amonbenson/esp.seq/hardware/esp.seq/esp.seq.kicad_pcb

## KiCad design hardware/esp.seq/esp.seq.kicad_pcb (2022-11-18)

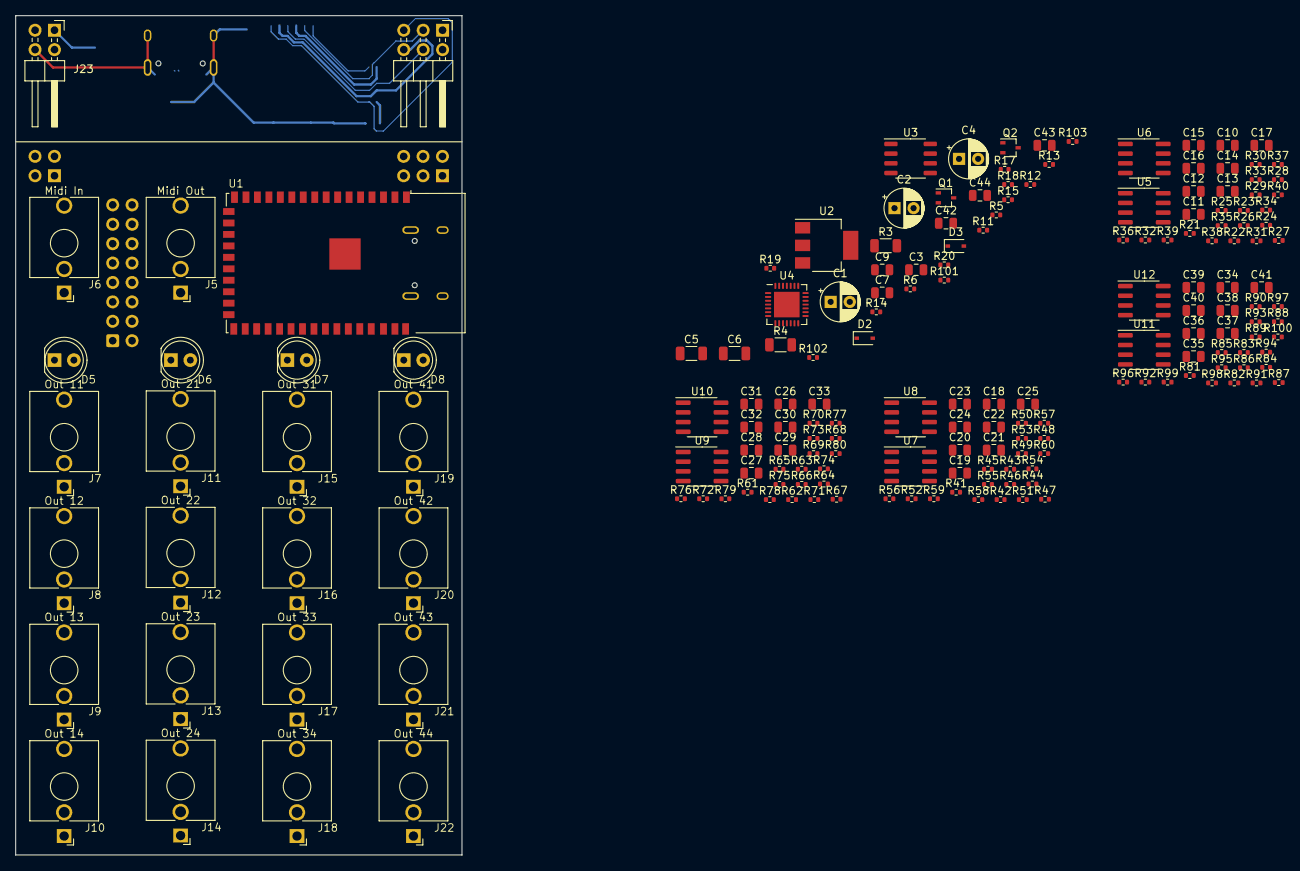
[picture p1: board esp.seq.kicad_pcb from above]

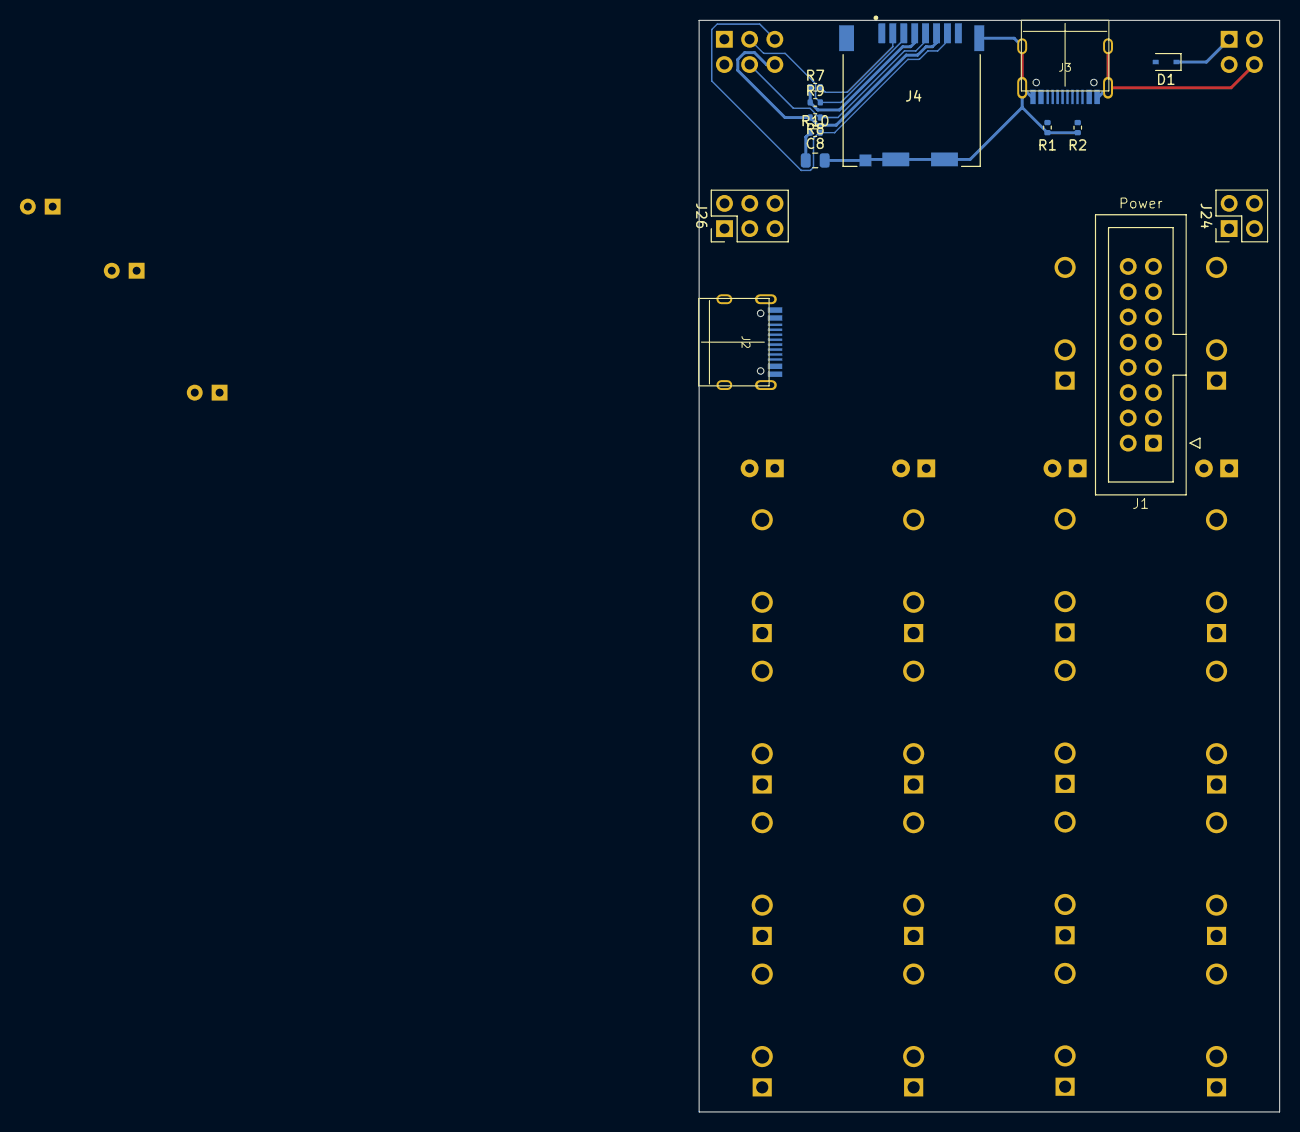
[picture p2: board esp.seq.kicad_pcb from below]

Board: 2 copper layers, 58.4 x 109.9 mm, 193 parts (14 on the bottom side), 149 nets.

Parts:
C1, C2, C4: 10u; CP_Radial_D5.0mm_P2.50mm
C3, C7, C8, C44: 100n; C_0805_2012Metric
C5, C6: 22u; C_1206_3216Metric
C9, C42: 1u; C_0805_2012Metric
C10, C12, C14, C16, C18, C20, C22, C24, C26, C28, C30, C32, C34, C36, C38, C40: 470n; C_0805_2012Metric
C11, C13, C15, C17, C19, C21, C23, C25, C27, C29, C31, C33, C35, C37, C39, C41: 220n; C_0805_2012Metric
C43: 10u; C_0805_2012Metric
D1, D3: 1N5819WS; D_SOD-323
D2: 1N4148WS; D_SOD-323
D5, D6, D7, D8: LED_Red; LED_D5.0mm
J1: Conn_02x08; IDC-Header_2x08_P2.54mm_Vertical
J2, J3: USB-C; TYPE-C-31-M-12
J4: Micro_SD_Card; HRS_DM3CS-SF
J5, J6: PJ-301M-3
J7, J8, J9, J10, J11, J12, J13, J14, J15, J16, J17, J18, J19, J20, J21, J22: PJ-301M-2
J23: Conn_01x04_Male; PinHeader_2x02_P2.54mm_Horizontal
J24: Conn_01x04_Male; PinHeader_2x02_P2.54mm_Vertical
J25: Conn_01x06_Male; PinHeader_2x03_P2.54mm_Horizontal
J26: Conn_01x06_Male; PinHeader_2x03_P2.54mm_Vertical
Q1, Q2: SS8050; SOT-323_SC-70
R1, R2, R11, R12: 5.1k; R_0402_1005Metric
R3, R4: 47; R_1206_3216Metric
R5, R17, R18, R19, R20: 220; R_0402_1005Metric
R6: 470; R_0402_1005Metric
R7, R8, R9, R10, R14: 47k; R_0402_1005Metric
R13: 22k; R_0402_1005Metric
R15, R25, R30, R35, R40, R45, R50, R55, R60, R65, R70, R75, R80, R85, R90, R95, R100: 1k; R_0402_1005Metric
R21, R22, R26, R27, R31, R32, R36, R37, R41, R42, R46, R47, R51, R52, R56, R57, R61, R62, R66, R67, R71, R72, R76, R77, R81, R82, R86, R87, R91, R92, R96, R97, R101, R102, R103: 10k; R_0402_1005Metric
R23, R28, R33, R38, R43, R48, R53, R58, R63, R68, R73, R78, R83, R88, R93, R98: 220k; R_0402_1005Metric
R24, R34, R44, R54, R64, R74, R84, R94: 330k; R_0402_1005Metric
R29, R39, R49, R59, R69, R79, R89, R99: 100k; R_0402_1005Metric
U1: ESP32-S2-WROVER
U2: AMS1117-3.3; SOT-223-3_TabPin2
U3: 6N137; SO-8_3.9x4.9mm_P1.27mm
U4: CP2102; QFN-28-1EP_5x5mm_P0.5mm_EP3.35x3.35mm
U5, U6, U7, U8, U9, U10, U11, U12: TL072; SOIC-8_3.9x4.9mm_P1.27mm

Connections:
+3.3V: C6.1, C43.2, C44.2, J26.1, R3.2, R6.1, R15.1, R103.2, U1.2 (3V3), U2.2 (VO), U4.6 (VDD), U4.7 (VREGIN)
+5V: C4.1, C5.1, C7.1, D3.1 (K), J1.11, J1.12, J24.1, U2.3 (VI), U3.8 (VCC)
+12V: C1.1, C3.2, J1.9, J1.10, U5.8 (V+), U6.8 (V+), U7.8 (V+), U8.8 (V+), U9.8 (V+), U10.8 (V+), U11.8 (V+), U12.8 (V+)
-12V: C2.2, C3.1, J1.1, J1.2, U5.4 (V-), U6.4 (V-), U7.4 (V-), U8.4 (V-), U9.4 (V-), U10.4 (V-), U11.4 (V-), U12.4 (V-)
/CON_+3.3V: C8.1, J4.4 (VDD), J25.1, R7.1, R9.1, R10.1
/CON_+5V: D1.1 (K), J23.1
/CON_FSPI_CLK: J4.5 (CLK), J25.4, R8.1
/CON_FSPI_CS: J4.2 (DAT3/CD), J25.2, R7.2
/CON_FSPI_MISO: J4.7 (DAT0), J25.5, R10.2
/CON_FSPI_MOSI: J4.3 (CMD), J25.3, R9.2
/CON_USB_D+: J3.A6 (D+), J3.B6 (D+), J23.3
/CON_USB_D-: J3.A7 (D-), J3.B7 (D-), J23.2
/CON_VBUS: D1.2 (A), J3.A4 (VBUS), J3.A9 (VBUS), J3.B4 (VBUS), J3.B9 (VBUS)
DTR: Q2.2 (E), R101.1, U4.28 (~DTR)
EN: C42.1, Q1.3 (C), R103.1, U1.41 (EN)
FSPI_CLK: J26.4, U1.30 (IO36)
FSPI_CS: J26.2, U1.28 (IO34)
FSPI_MISO: J26.5, U1.31 (IO37)
FSPI_MOSI: J26.3, U1.29 (IO35)
GND: C1.2, C2.1, C4.2, C5.2, C6.2, C7.2, C9.2, C11.2, C13.2, C15.2, C17.2, C19.2, C21.2, C23.2, C25.2, C27.2, C29.2, C31.2, C33.2, C35.2, C37.2, C39.2, C41.2, C42.2, C43.1, C44.1, D5.1 (K), D6.1 (K), D7.1 (K), D8.1 (K), J1.3, J1.4, J1.5, J1.6, J1.7, J1.8, J2.A1 (GND), J2.A12 (GND), J2.B1 (GND), J2.B12 (GND), J2.S1 (SHIELD), J5.S, J7.S, J8.S, J9.S, J10.S, J11.S, J12.S, J13.S, J14.S, J15.S, J16.S, J17.S, J18.S, J19.S, J20.S, J21.S, J22.S, J24.4, J26.6, R11.2, R12.2, R14.1, R24.2, R29.2, R34.2, R39.2, R44.2, R49.2, R54.2, R59.2, R64.2, R69.2, R74.2, R79.2, R84.2, R89.2, R94.2, R99.2, U1.1 (GND), U1.26 (GND), U1.42 (GND), U1.43 (GND), U2.1 (GND), U3.5 (GND), U4.3 (GND), U4.29 (GND)
GND1: C8.2, J3.A1 (GND), J3.A12 (GND), J3.B1 (GND), J3.B12 (GND), J3.S1 (SHIELD), J4.6 (VSS), J4.9 (SHIELD), J23.4, J25.6, R1.2, R2.2, R8.2
IO0: Q2.3 (C), U1.3 (IO00)
IO1: R21.1, U1.4 (IO01)
IO2: R26.1, U1.5 (IO02)
IO3: R31.1, U1.6 (IO03)
IO4: R36.1, U1.7 (IO04)
IO5: R41.1, U1.8 (IO05)
IO6: R46.1, U1.9 (IO06)
IO7: R51.1, U1.10 (IO07)
IO8: R56.1, U1.11 (IO08)
IO9: R61.1, U1.12 (IO09)
IO10: R66.1, U1.13 (IO10)
IO11: R71.1, U1.14 (IO11)
IO12: R76.1, U1.15 (IO12)
IO13: R81.1, U1.16 (IO13)
IO14: R86.1, U1.17 (IO14)
IO15: R91.1, U1.18 (IO15)
IO16: R96.1, U1.19 (IO16)
IO39: R17.1, U1.33 (IO39)
IO40: R18.1, U1.34 (IO40)
IO41: R19.1, U1.35 (IO41)
IO42: R20.1, U1.36 (IO42)
unnamed: C9.1, R13.1, R14.2, U4.8 (VBUS)
unnamed: C10.1, R23.1, R25.1, U5.1
unnamed: C10.2, R21.2, R22.1
unnamed: C11.1, R22.2, U5.3 (+)
unnamed: C12.1, R28.1, R30.1, U5.7
unnamed: C12.2, R26.2, R27.1
unnamed: C13.1, R27.2, U5.5 (+)
unnamed: C14.1, R33.1, R35.1, U6.1
unnamed: C14.2, R31.2, R32.1
unnamed: C15.1, R32.2, U6.3 (+)
unnamed: C16.1, R38.1, R40.1, U6.7
unnamed: C16.2, R36.2, R37.1
unnamed: C17.1, R37.2, U6.5 (+)
unnamed: C18.1, R43.1, R45.1, U7.1
unnamed: C18.2, R41.2, R42.1
unnamed: C19.1, R42.2, U7.3 (+)
unnamed: C20.1, R48.1, R50.1, U7.7
unnamed: C20.2, R46.2, R47.1
unnamed: C21.1, R47.2, U7.5 (+)
unnamed: C22.1, R53.1, R55.1, U8.1
unnamed: C22.2, R51.2, R52.1
unnamed: C23.1, R52.2, U8.3 (+)
unnamed: C24.1, R58.1, R60.1, U8.7
unnamed: C24.2, R56.2, R57.1
unnamed: C25.1, R57.2, U8.5 (+)
unnamed: C26.1, R63.1, R65.1, U9.1
unnamed: C26.2, R61.2, R62.1
unnamed: C27.1, R62.2, U9.3 (+)
unnamed: C28.1, R68.1, R70.1, U9.7
unnamed: C28.2, R66.2, R67.1
unnamed: C29.1, R67.2, U9.5 (+)
unnamed: C30.1, R73.1, R75.1, U10.1
unnamed: C30.2, R71.2, R72.1
unnamed: C31.1, R72.2, U10.3 (+)
unnamed: C32.1, R78.1, R80.1, U10.7
unnamed: C32.2, R76.2, R77.1
unnamed: C33.1, R77.2, U10.5 (+)
unnamed: C34.1, R83.1, R85.1, U11.1
unnamed: C34.2, R81.2, R82.1
unnamed: C35.1, R82.2, U11.3 (+)
unnamed: C36.1, R88.1, R90.1, U11.7
unnamed: C36.2, R86.2, R87.1
unnamed: C37.1, R87.2, U11.5 (+)
unnamed: C38.1, R93.1, R95.1, U12.1
unnamed: C38.2, R91.2, R92.1
unnamed: C39.1, R92.2, U12.3 (+)
unnamed: C40.1, R98.1, R100.1, U12.7
unnamed: C40.2, R96.2, R97.1
unnamed: C41.1, R97.2, U12.5 (+)
unnamed: D2.1 (K), R5.2, U3.2 (A)
unnamed: D2.2 (A), J5.T, U3.3 (C)
unnamed: D5.2 (A), R17.2
unnamed: D6.2 (A), R18.2
unnamed: D7.2 (A), R19.2
unnamed: D8.2 (A), R20.2
unnamed: J2.A5 (CC1), R12.1
unnamed: J2.B5 (CC2), R11.1
unnamed: J3.A5 (CC1), R2.1
unnamed: J3.B5 (CC2), R1.1
unnamed: J5.R, R5.1
unnamed: J6.R, R3.1
unnamed: J6.T, R4.1
unnamed: Q1.1 (B), R101.2
unnamed: Q2.1 (B), R102.2
unnamed: R15.2, U4.9 (~RST)
unnamed: R23.2, R24.1, U5.2 (-)
unnamed: R28.2, R29.1, U5.6 (-)
unnamed: R33.2, R34.1, U6.2 (-)
unnamed: R38.2, R39.1, U6.6 (-)
unnamed: R43.2, R44.1, U7.2 (-)
unnamed: R48.2, R49.1, U7.6 (-)
unnamed: R53.2, R54.1, U8.2 (-)
unnamed: R58.2, R59.1, U8.6 (-)
unnamed: R63.2, R64.1, U9.2 (-)
unnamed: R68.2, R69.1, U9.6 (-)
unnamed: R73.2, R74.1, U10.2 (-)
unnamed: R78.2, R79.1, U10.6 (-)
unnamed: R83.2, R84.1, U11.2 (-)
unnamed: R88.2, R89.1, U11.6 (-)
unnamed: R93.2, R94.1, U12.2 (-)
unnamed: R98.2, R99.1, U12.6 (-)
OUT11: J7.T, R25.2
OUT12: J8.T, R30.2
OUT13: J9.T, R35.2
OUT14: J10.T, R40.2
OUT21: J11.T, R45.2
OUT22: J12.T, R50.2
OUT23: J13.T, R55.2
OUT24: J14.T, R60.2
OUT31: J15.T, R65.2
OUT32: J16.T, R70.2
OUT33: J17.T, R75.2
OUT34: J18.T, R80.2
OUT41: J19.T, R85.2
OUT42: J20.T, R90.2
OUT43: J21.T, R95.2
OUT44: J22.T, R100.2
RTS: Q1.2 (E), R102.1, U4.24 (~RTS)
U0RXD: U1.38 (RXD0), U4.26 (TXD)
U0TXD: U1.37 (TXD0), U4.25 (RXD)
U1RXD: R6.2, U1.21 (IO18), U3.6 (VO)
U1TXD: R4.2, U1.20 (IO17)
UART_D+: J2.A6 (D+), J2.B6 (D+)
UART_D-: J2.A7 (D-), J2.B7 (D-), U4.4 (D+), U4.5 (D-)
USB_D+: J24.3, U1.23 (USB_D+)
USB_D-: J24.2, U1.22 (USB_D-)
VBUS: D3.2 (A), J2.A4 (VBUS), J2.A9 (VBUS), J2.B4 (VBUS), J2.B9 (VBUS), R13.2
