amonbenson/esp.seq/(commit log)

2022-05-02 flashing via uart1 finally working
2022-05-02 usb device open close cycle working
2022-05-03 restructure of midi driver
2022-05-05 added tasks, some bugfixes
    [main.c]
2022-05-31 added basic event system to sequencer
    [channel_configurations.txt]
2022-05-31 added track events
2022-10-09 preparing pwm version
2022-10-23 added gate and probability settings to steps, bugfixes
    [main.c]
2022-10-28 first working tests
    [channel_configurations.txt]
2022-10-29 reworked output module to be more generic
    [main.c, output.c, output.h]
2022-10-29 reworked pin layout
2022-11-01 added kicad files
    [esp.seq.kicad_pcb, esp.seq.kicad_sch, output_stage.kicad_sch, untitled.kicad_sch]
2022-11-02 footprint and layout updates
    [esp.seq.kicad_pcb, esp.seq.kicad_sch, output_stage.kicad_sch]
2022-11-18 added pwm control
2022-11-18 reworked sequencer event routing
    [main.c, output.h]
2022-11-21 switched to new callback system
2022-12-21 added play button
2024-04-14 updated cpp props
